zfrew/veneervases/Vase Stand STL .STL

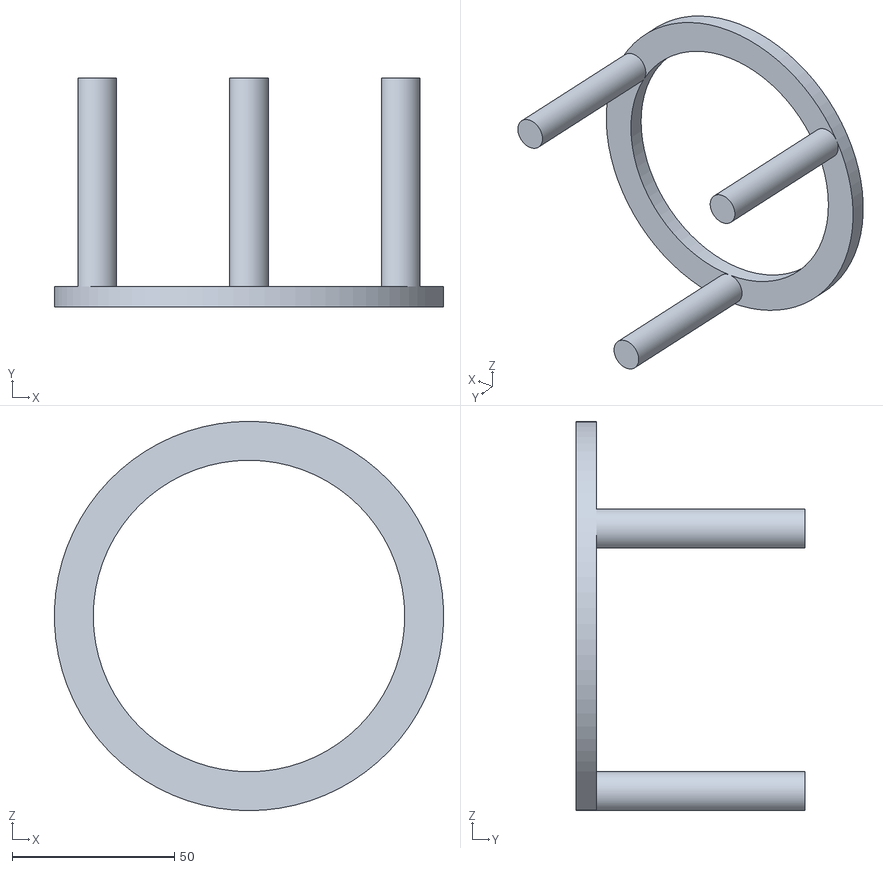
[picture p1: CAD file, 2020-08-30]
Vase Stand STL .STL
119.9 x 70.6 x 120.0
