zfrew/veneervases/Wood Veneer DXF.DXF

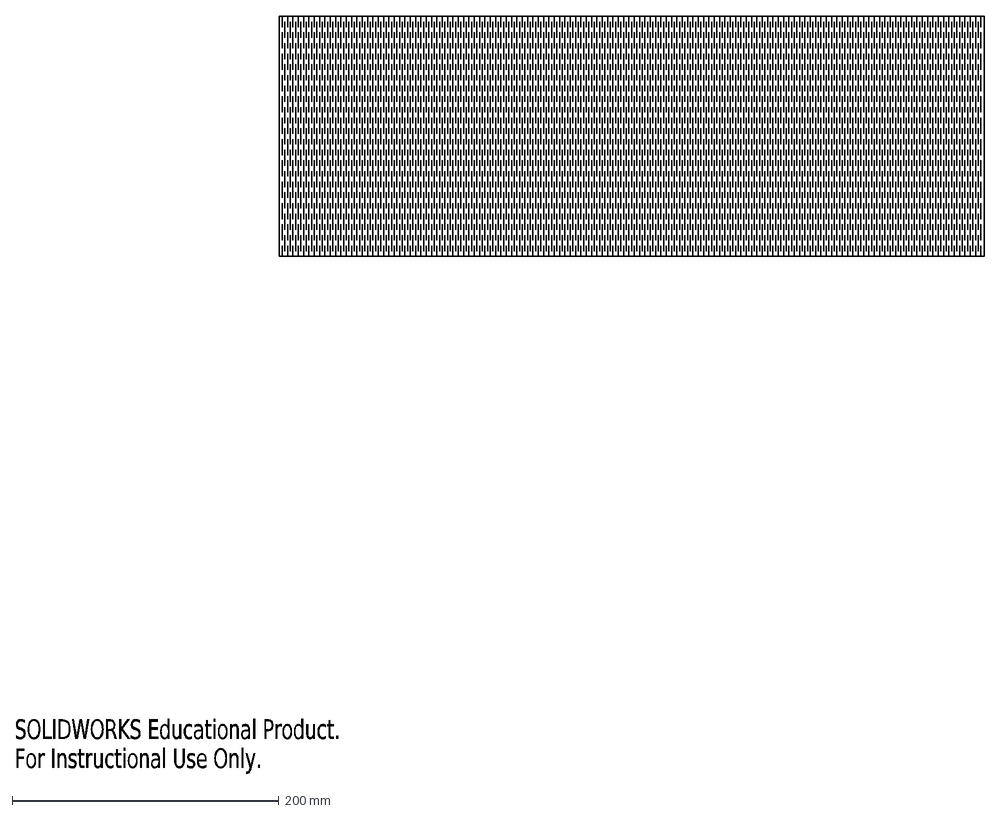
[picture p2: CAD file, 2020-08-30]
Wood Veneer DXF.DXF
SOLIDWORKS Educational Product.
For Instructional Use Only.
