zfrew/veneervases/Lasercut Base DXF.DXF

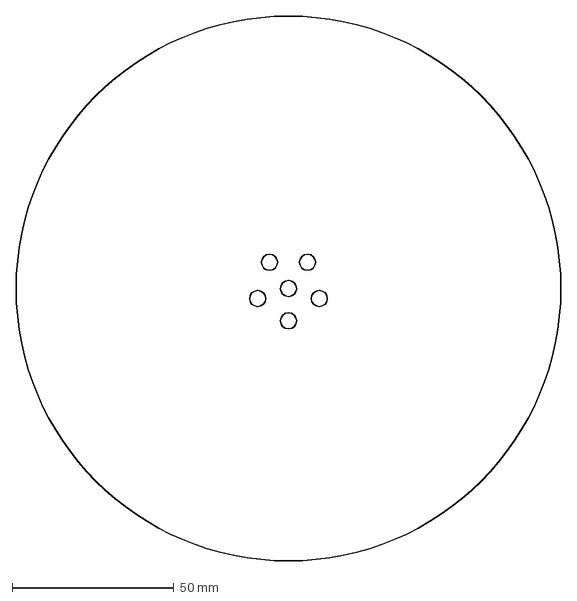
[picture p3: CAD file, 2020-08-30]
Lasercut Base DXF.DXF
168.3 x 168.3 mm
